SaLanc/SaLAltimeter/partslist final.xlsx

Qty | Value | Device | Package | Parts | Description | manufacture | part # | digikey part
11 | 47nF | CAP0402-CAP | 0402-CAP | C21, C23, C24, C25, C26, C27, C30, C31, C33, C34, C35 | Capacitor | Murata | GRM155R71E473KA88D | 490-3254-1-ND
8 | 0.1uF | CAP0402-CAP | 0402-CAP | C3, C4, C5, C8, C9, C10, C11, C39 | Capacitor | Murata | GRM155R61A104KA01D | 490-1318-1-ND
6 | 10k | RESISTOR0402-RES | 0402-RES | R1, R2, R3, R4, R13, R20 | Resistor | Samsung | RC1005F103CS | 1276-3431-1-ND
4 | 15pF | CAP0402-CAP | 0402-CAP | C6, C7, C28, C29 | Capacitor | Murata | GRM1555C1H150JA01D | 490-5888-1-ND
3 | 5.1pF | CAP0402-CAP | 0402-CAP | C15, C18, C19 | Capacitor | Murata | GRM1555C1H5R1CA01D | 490-8216-1-ND
3 | STAND-OFF | STAND-OFF | STAND-OFF | STANDOFF1, STANDOFF2, STANDOFF3 | #4 Stand Off
2 | 10nF | CAP0402-CAP | 0402-CAP | C20, C37 | Capacitor | Murata | GRM155R71E103KA01D | 490-1312-1-ND
2 | 2.2uF | CAP0603-CAP | 0603-CAP | C1, C2 | Capacitor | Samsung | CL10A225KQ8NNNC | 1276-1183-1-ND
2 | 15nH | INDUCTOR0402 | C0402 | L2, L6 | Inductors | Murata | LQW15AN15NJ00D | 490-1148-1-ND
2 | 27nH | INDUCTOR0402 | C0402 | L8, L9 | Inductors | Murata | LQW15AN27NJ00D | 490-1151-1-ND
2 | 56nH | INDUCTOR0402 | C0402 | L5, L7 | Inductors | Murata | LQW15AN56NJ00D | 490-1155-1-ND
2 | 100 | RESISTOR0402 | 0402-RES | R6, R7 | Resistor | Samsung | RC1005F101CS | 1276-3429-1-ND
3 | 100K | RESISTOR0402 | 0402-RES | R9, R11, R18 | Resistor | Samsung | RC1005F104CS | 1276-3432-1-ND
3 | 27K | RESISTOR0402 | 0402-RES | R10, R12, R19 | Resistor | Samsung | RC1005F273CS | 1276-4153-1-ND
2 | 3.3k | RESISTOR0402 | 0402-RES | R5, R8 | Resistor | Samsung | RC1005F332CS | 1276-3460-1-ND
1 | ADXL345 | ADXL345 | LGA14 | U3 | 3-axis SPI/I2C 2/4/8/16g accelerometer | Analog Devices | ADXL345BCCZ-RL | ADXL345BCCZ-RLCT-ND
1 | AT25SF081 | AT25SF081 | AT25SF081 | MEM | AT25SF081 - 8M memory smd | Adesto Technologies | AT25SF081-SSHD-T | 1265-1133-1-ND
1 | ATSAMD21G-A | ATSAMD21G-A | TQFP-48 | U1 | Atmel SAMD21G SMART ARM-Based Microcontroller | Atmel | ATSAMD21G18A-AUT | ATSAMD21G18A-AUTCT-ND
1 | BUZZERSMD2 | BUZZERSMD2 | BUZZER-CCV | SG1 | Buzzer 12mm | CUI Inc. | CBT-09427-SMT-TR | 102-1265-1-ND
1 | 1.8nF | CAP0402-CAP | 0402-CAP | C22 | Capacitor | Murata | GRM1557U1A182JA01D | 490-6274-1-ND
1 | 100pF | CAP0402-CAP | 0402-CAP | C38 | Capacitor | Murata | GRM1555C1H101JA01D | 490-5922-1-ND
1 | 10uF | CAP0402-CAP | 0402-CAP | C12 | Capacitor | Vishay Sprague | 298D106X0004K2T | 718-1615-1-ND
1 | 2.2pF | CAP0402-CAP | 0402-CAP | C14 | Capacitor | Murata | GRM1555C1H2R2CA01D | 490-5932-1-ND
1 | 220nF | CAP0402-CAP | 0402-CAP | C32 | Capacitor | Murata | GRM155R61A224KE19J | 490-6303-1-ND
1 | 39pF | CAP0402-CAP | 0402-CAP | C13 | Capacitor | Murata | GRM1555C1H390JA01D | 490-5871-1-ND
1 | 56pF | CAP0402-CAP | 0402-CAP | C36 | Capacitor | no mount
1 | 6.2pF | CAP0402-CAP | 0402-CAP | C17 | Capacitor | Murata | GRM1555C1H6R2CA01D | 490-11401-1-ND
1 | CC1120 | CC1120 | CC1120 | U2 |  | Texas Instruments | CC1120RHBR | 296-35667-1-ND
1 | CORTEX_DEBUGPTH | CORTEX_DEBUGPTH | 2X5-PTH-1.27MM | JP1 | Cortex Debug Connector | FCI | 20021111-00010T4LF | 609-3712-ND
1 | 32.768kHx | CRYSTAL3.2X1.5MM | CRYSTAL-SMD-3.2X1.5MM | Y1 | Various standard crystals. Proven footprints. | Citizen Finedevice Co Ltd | CM315D32768EZFT | 300-8816-1-ND
1 | 32MHz | CRYSTAL5X3 | CRYSTAL-SMD-5X3 | Y3 | Various standard crystals. Proven footprints. | TXC CORPORATION | 7B-32.000MEEQ-T | 887-1312-1-ND
1 | FRAME-LEDGER | FRAME-LEDGER | CREATIVE_COMMONS | FRAME1 | Schematic Frame
1 | gps | GPS_FGPMMOPA6H | FGPMMOPA6H | U4 | GPS Module - MTK MT3339 Chipset, -165dBm sensitivity, 22 channels, 10Hz, auto-select external antenna options
1 | 22nH | INDUCTOR0402 | C0402 | L4 | Inductors | Murata | LQW15AN22NJ00D | 490-1150-1-ND
1 | 43nH | INDUCTOR0402 | C0402 | L3 | Inductors | Murata | LQW15AN43NJ00D | 490-6818-1-ND
1 | FB - 30Ohm | INDUCTOR0603 | 603 | L1 | Inductors | TDK Corporation | MMZ1608Y300BTA00 | 445-2185-1-ND
1 | BAT | JST_2MM_MALE | JST-2-SMD | J1 | Mates to single-cell LiPo batteries. | JST Sales America Inc. | S2B-PH-SM4-TB(LF)(SN) | 455-1749-1-ND
1 | RED | LED-RED0603 | LED-0603 | D1 | Assorted Red LEDs | Rohm Semiconductor |  | 511-1304-1-ND
1 | DROGUE | M022.54MM_SCREWTERM | 1X02_2.54_SCREWTERM | JP3 | Standard 2-pin 0.1 header. Use with"
1 | MAIN | M022.54MM_SCREWTERM | 1X02_2.54_SCREWTERM | JP2 | Standard 2-pin 0.1 header. Use with"
1 | MAX16054 | MAX16054 | MAX16054 | U$1 |  | Maxim Integrated | MAX16054AZT+T | MAX16054AZT+TCT-ND
1 | PTCSMD | PTCSMD | PTC-1206 | F1 | Resettable Fuse PTC | Eaton Bussmann |  | 283-3137-1-ND
1 | 0ohm | RESISTOR0402-RES | 0402-RES | R14 | Resistor | Samsung | RC1005J000CS | 1276-3480-1-ND
1 | 18 | RESISTOR0402-RES | 0402-RES | R15 | Resistor | Samsung | RC1005F180CS | 1276-3893-1-ND
1 | 301ohm | RESISTOR0402-RES | 0402-RES | R17 | Resistor | Samsung | RC1005F3010CS | 1276-3975-1-ND
1 | 56KOhm | RESISTOR0402-RES | 0402-RES | R16 | Resistor | Samsung | RC1005F563CS | 1276-4182-1-ND
1 | SI7232DN | SI7232DN | SI7232DN | U$6 | SI7232DN dual | Vishay Siliconix | SI7232DN-T1-GE3 | SI7232DN-T1-GE3CT-ND
1 | SI7615ADN | SI7615ADN | SI7615ADN | U$3 |  | Vishay Siliconix | SI7615ADN-T1-GE3 | SI7615ADN-T1-GE3CT-ND
1 | SIMPLE-MS5607 | SIMPLE-MS5607 | MS5607 | U$5 |  | TE Connectivity Measurement Specialties | MS560702BA03-50 | 223-1198-1-ND
1 | SMA_EDGE | SMA_EDGE | SMA-EDGE | J$1 | SMA Antenna Connector | Cinch Connectivity Solutions Johnson |  | J502-ND
1 | SS345PT | SS345PT | SS345PT | U$2 |  | Honeywell Sensing and Productivity Solutions | SS345PT | 480-5194-1-ND
1 | SWITCH-MOMENTARY-2SMD-4.6X2.8MM | SWITCH-MOMENTARY-2SMD-4.6X2.8MM | TACTILE_SWITCH_SMD_4.6X2.8MM | S2 | Various NO switches- pushbuttons, reed, etc | C&K Components |  | CKN10284CT-ND
1 | USB-MICROB | USB-MICROB | USB-MICROB | JP4 | USB Connectors |  |  | PRT-08533 ROHS
1 | V_REG_LDOSMD | V_REG_LDOSMD | SOT23-5 | 1U2 | Voltage Regulator LDO | Texas Instruments | TPS73633MDBVREP | 296-21283-1-ND
