SaLanc/SaLAltimeter/SaLAltimeter.pdf

# 47nF³.3V

## Y1R¹

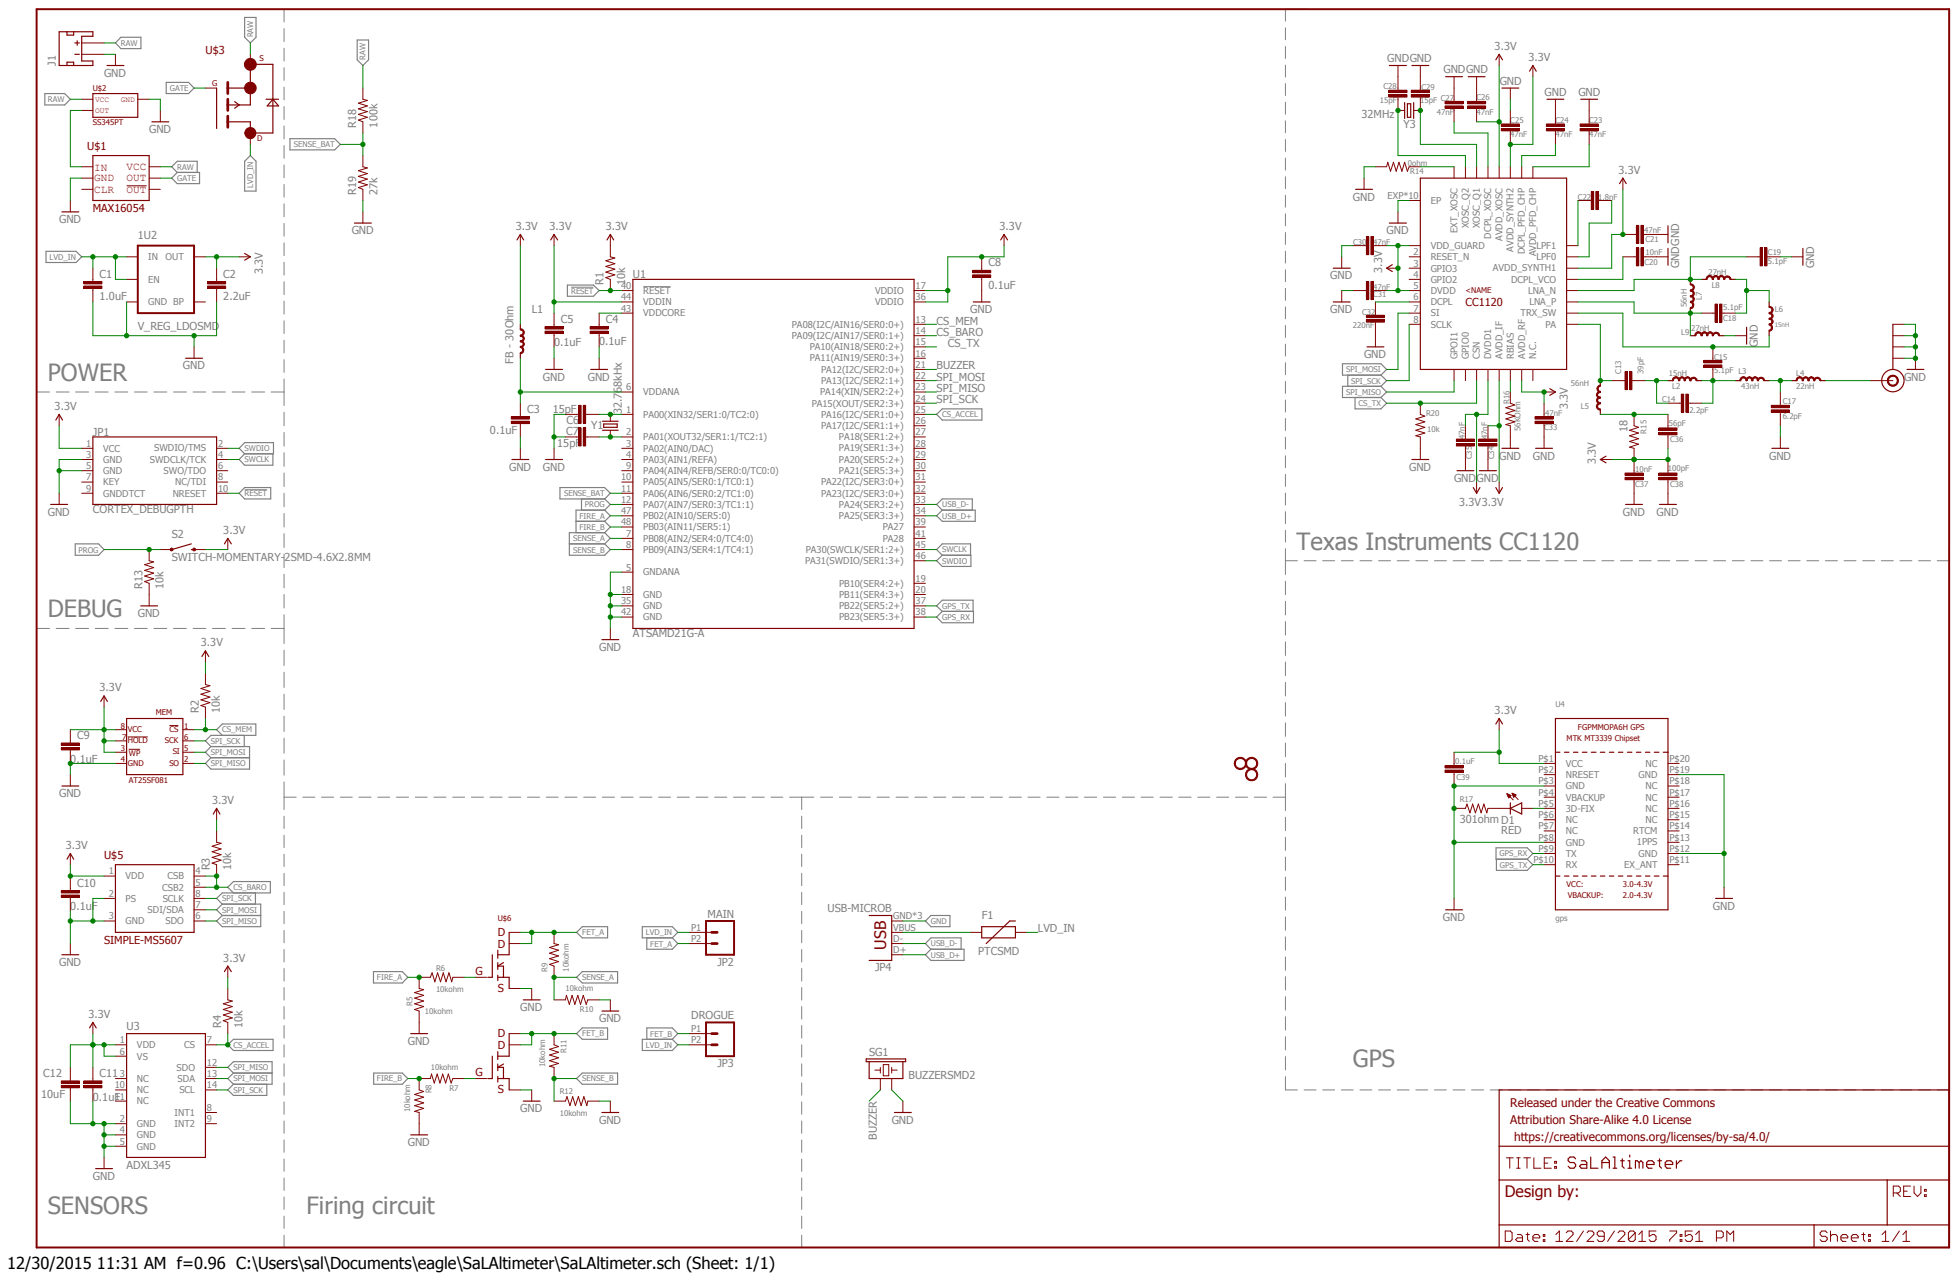
[picture p1: page 1]

Released under the Creative Commons
Attribution Share-Alike 4.0 License
https://creativecommons.org/licenses/by-sa/4.0/

12/30/2015 11:31 AM f=0.96 C:\Users\sal\Documents\eagle\SaLAltimeter\SaLAltimeter.sch (Sheet: 1/1)
