SaLanc/SaLAltimeter/SaLAltimeter.brd.pdf

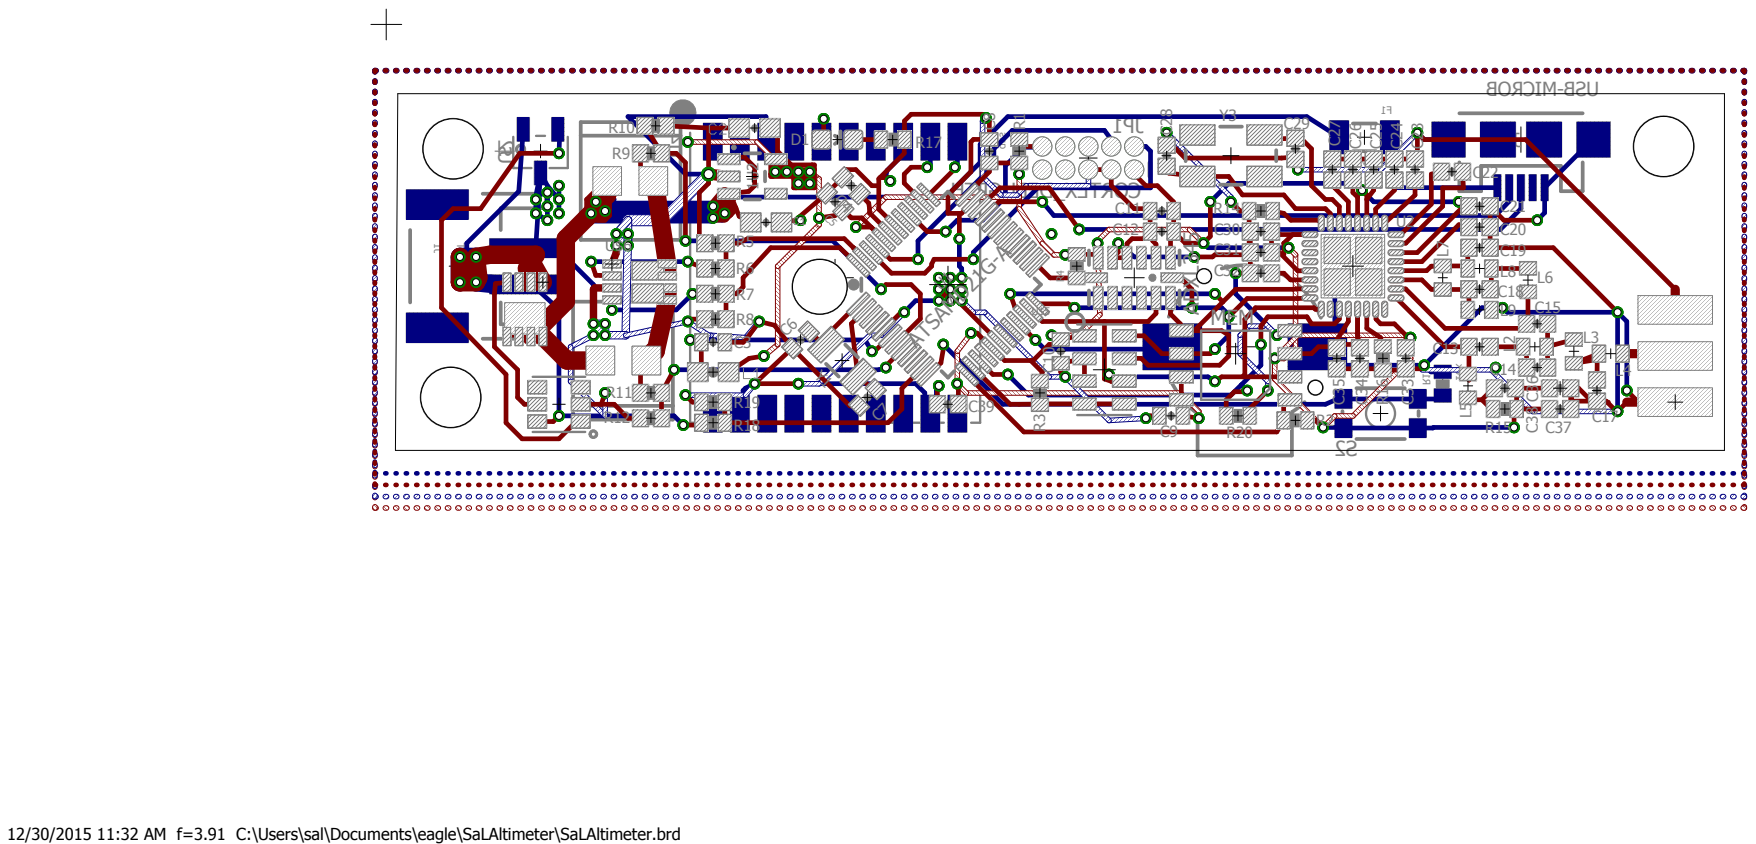
[picture p2: page 1]

12/30/2015 11:32 AM f=3.91 C:\Users\sal\Documents\eagle\SaLAltimeter\SaLAltimeter.brd BAT
