SaLanc/SaLAltimeter/(commit log)

2015-12-27 setting up board
    [SaLAltimeter.brd, SaLAltimeter.sch]
2015-12-27 added transmiter
    [SaLAltimeter.brd]
2015-12-27 fixed gps
    [SaLAltimeter.brd, SaLAltimeter.sch]
2015-12-28 aligned tx parts
    [SaLAltimeter.brd, SaLAltimeter.sch]
2015-12-28 starting 4 layer routing
    [SaLAltimeter.brd]
2015-12-28 lots of work on the layout
    [SaLAltimeter.brd, SaLAltimeter.sch]
2015-12-28 squished it all inside
    [SaLAltimeter.brd]
2015-12-29 starting wiring
    [SaLAltimeter.brd, SaLAltimeter.sch]
2015-12-29 more wiring
    [SaLAltimeter.brd, SaLAltimeter.sch]
2015-12-30 finshed wiring
    [SaLAltimeter.brd, SaLAltimeter.sch]
2015-12-30 mk1 finished!
    [SaLAltimeter.brd, SaLAltimeter.sch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]
2016-01-18 parts lists added
    [SaLAltimeter.brd, SaLAltimeter.sch, partslist final.xlsx, partslist.xlsx, partslist2.xlsx]
